xonik/noise-a6-pcb/Extended parts.txt

Extended parts, Noise

Missing parts in bom:
TL074
