xonik/noise-a6-pcb/attic/Xonik Noise A6 w.logo.brd

## EAGLE design attic/Xonik Noise A6 w.logo.brd (2018-01-27, an earlier design)

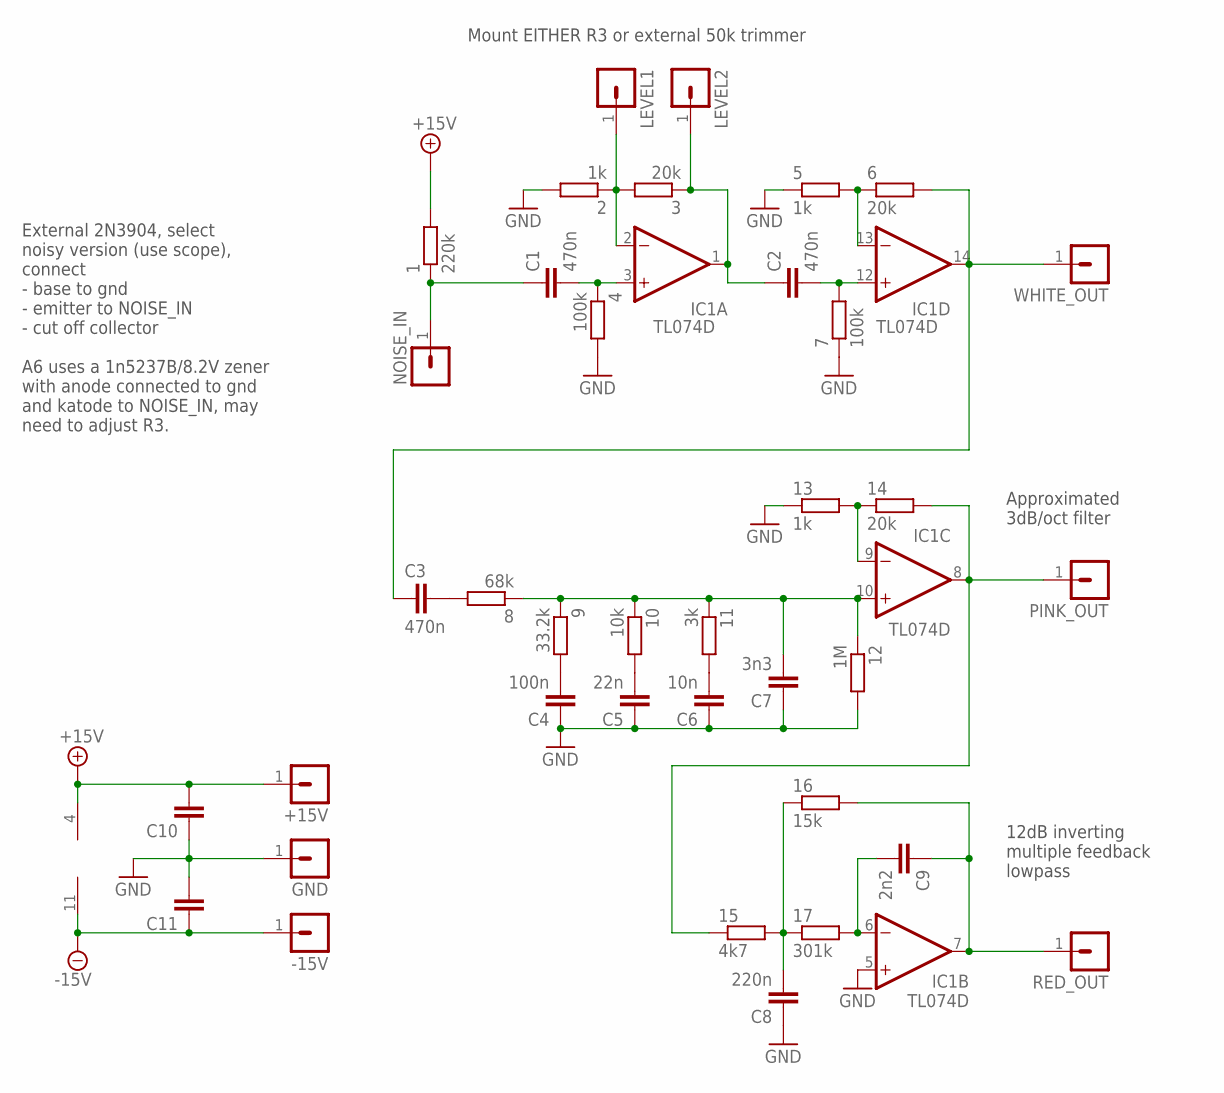
[picture p1: schematic Xonik Noise A6 w.logo.sch]

Parts:
1: 220k; R0805
2, 5, 13: 1k; R0805
3, 6, 14: 20k; R0805
4, 7: 100k; R0805
8: 68k; R0805
9: 33.2k; R0805
10: 10k; R0805
11: 3k; R0805
12: 1M; R0805
15: 4k7; R0805
16: 15k; R0805
17: 301k; R0805
+15V: MA01-1JP; SIP-PIN01-1J
-15V: MA01-1JP; SIP-PIN01-1J
C1, C2, C3: 470n; C0805
C4: 100n; C0805
C5: 22n; C0805
C6: 10n; C0805
C7: 3n3; C0805
C8: 220n; C0805
C9: 2n2; C0805
C10, C11: C-EUC0603; C0603
GND: MA01-1JP; SIP-PIN01-1J
IC1: TL074D; SO14
LEVEL1, LEVEL2: MA01-1JP; SIP-PIN01-1J
NOISE_IN: MA01-1JP; SIP-PIN01-1J
PINK_OUT: MA01-1JP; SIP-PIN01-1J
RED_OUT: MA01-1JP; SIP-PIN01-1J
WHITE_OUT: MA01-1JP; SIP-PIN01-1J

Connections:
+15V: 1.2, +15V.1, C10.2, IC1.4 (V+)
-15V: -15V.1, C11.1, IC1.11 (V-)
GND: 2.2, 4.2, 5.1, 7.1, 12.2, 13.1, C4.1, C5.1, C6.1, C7.1, C8.1, C10.1, C11.2, GND.1, IC1.5 (+IN)
unnamed: 2.1, 3.2, IC1.2 (-IN), LEVEL1.1
unnamed: 5.2, 6.1, IC1.13 (-IN)
unnamed: 13.2, 14.1, IC1.9 (-IN)
unnamed: 9.2, C4.2
unnamed: 10.2, C5.2
unnamed: 11.2, C6.2
unnamed: 1.1, C1.1, NOISE_IN.1
unnamed: 4.1, C1.2, IC1.3 (+IN)
unnamed: 3.1, C2.1, IC1.1 (OUT), LEVEL2.1
unnamed: 7.2, C2.2, IC1.12 (+IN)
unnamed: 6.2, C3.1, IC1.14 (OUT), WHITE_OUT.1
unnamed: 8.1, 9.1, 10.1, 11.1, 12.1, C7.2, IC1.10 (+IN)
unnamed: 8.2, C3.2
unnamed: 14.2, 15.1, IC1.8 (OUT), PINK_OUT.1
unnamed: 15.2, 16.1, 17.1, C8.2
unnamed: 17.2, C9.2, IC1.6 (-IN)
unnamed: 16.2, C9.1, IC1.7 (OUT), RED_OUT.1

Notes on the sheet:
Mount EITHER R3 or external 50k trimmer
Approximated 3dB/oct filter
12dB inverting multiple feedback lowpass
External 2N3904, select noisy version (use scope), connect - base to gnd - emitter to NOISE_IN - cut off collector A6 uses a 1n5237B/8.2V zener with anode connected to gnd and katode to NOISE_IN, may need to adjust R3.

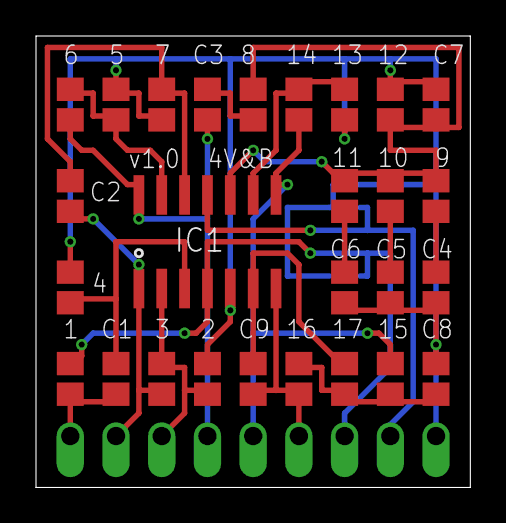
[picture p2: board Xonik Noise A6 w.logo.brd from above]

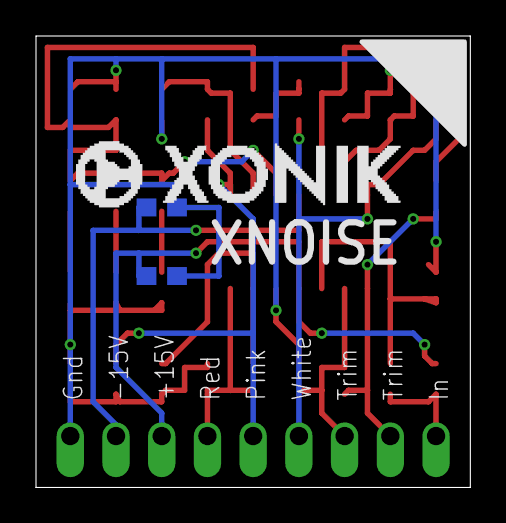
[picture p3: board Xonik Noise A6 w.logo.brd from below]

Board: 2 copper layers, 24.1 x 25.1 mm, 38 parts (2 on the bottom side), 20 nets.
