xonik/noise-a6-pcb/(commit log)

2017-10-08 Xonik Noise A6 - Andromeda A6 based noise circuit with some values changed
    [Xonik Noise A6.sch]
2017-10-09 Routing completed except for error checking.
    [Xonik Noise A6.brd, Xonik Noise A6.sch]
2018-01-27 new versions
    [Xonik Noise A6 w.logo.brd, Xonik Noise A6 w.logo.sch]
2020-02-15 Version 2 with screw hole, on board noisy tranny, fixed entry point for smd resistor paths etc
    [Xonik Noise A6 w.logo v2.0.brd, Xonik Noise A6 w.logo v2.0.sch]
2020-02-17 Vector xonik logo
    [Xonik Noise A6 w.logo v2.0.brd]
2020-02-18 Added parts list for smd assembly
    [Xonik Noise A6 w.logo v2.0_top_bom.csv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]
2020-02-20 Removed default gain resistor and added doc for trimmer
    [Xonik Noise A6 w.logo v2.0.brd, Xonik Noise A6 w.logo v2.0.sch]
2020-02-22 Changed to logo-as-component
    [Xonik Noise A6 w.logo v2.0.brd]
2020-03-02 Added working bom and gerber
    [Xonik Noise A6 w.logo v2.0.brd, Xonik Noise A6 w.logo v2.0.sch, Xonik Noise A6 w.logo v2.0_top_bom_2020-03-02.csv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]
2020-03-03 Added comment about trimmer
    [Xonik Noise A6 w.logo v2.0.sch]
2020-06-21 Changed recommended external trimmer for 50k to 100k to be able to reach a high enough amplitude
    [Panelize - Xonik Noise A6 w.logo v2.0.brd, Panelize - Xonik Noise A6 w.logo v2.0.sch]
2023-03-13 Working on 12v version with 0603 res
    [Xonik Noise A6 w.logo v2.1-12v.brd, Xonik Noise A6 w.logo v2.1-12v.sch]
2023-03-13 Version 2.1 12V completed I think
    [Xonik Noise A6 w.logo v2.1-12v.brd, Xonik Noise A6 w.logo v2.1-12v.sch]
2023-03-13 Tiny tweaks
    [Xonik Noise A6 w.logo v2.1-12v.brd]
2023-03-14 Angled corner. Finally.
    [Xonik Noise A6 w.logo v2.1-12v.brd]
